marten619/RemoteController/HW design/PCB DIMENSIONS/RC-RF004-HCS200_V1.a PCB DIMENSIONS.PcbDoc.htm

Altium Reporting Options

# File in Newer Format

Date | : | 2017/11/13
Time | : | ¤U¤È 06:21:15
Filename | : | D:\Pmaster\Projects\Remote Control\HW design\PCB DIMENSIONS\RC-RF004-HCS200_V1.a PCB DIMENSIONS.PcbDoc

Version | Warning
Release 10 | CAUTION - New Custom Grids and Guides were introduced. Be aware that your design might contain Custom Grids and Guides that cannot be read in previous versions.
Release 10 | CAUTION - New Structured Clusters were introduced. Be aware that your design might contain Structured Clusters that cannot be read in previous versions.
Release 10 | CAUTION - New PCB 3D Movie Manager was introduced. Be aware that your design might contain 3D PCB movie that cannot be read in previous versions.
Release 10 update 1 | CAUTION - New Clearance Rule subscopes targeting differential pairs were introduced. Be aware that your design might contain Clearance Rules using those subscopes that cannot be read in previous versions.
Release 10 update 15 | CAUTION - Support of Solder Mask and Paste Mask expansions for Tracks, Arcs, Fills and Regions was introduced. Be aware that your design might contain Solder Mask and Paste Mask expansions for these types of primitives that cannot be read in the version of Altium Designer you are currently using.
Altium Designer update 19 | CAUTION - Air Gap Width attribute was introduced to Polygon Connect Style Rule. Be aware that your design might contain Polygon Connect Style Rules with new Air Gap Width attribute cannot be read in the version of Altium Designer you are currently using.

This file was generated by a later version of the software
