marten619/RemoteController/datasheet/TS06-050W.png

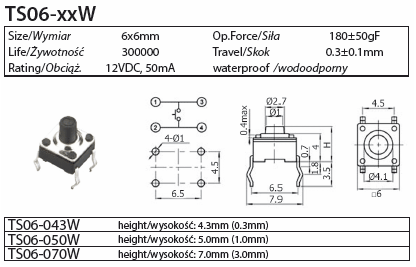
datasheet/TS06-050W.png
