marten619/RemoteController/HW design/BOM/Pmaster-A9112-HOST_1.xls

Sheet: BOM Report
Bill of Materials |  |  | Bill of Materials For PCB Document [Pmaster-A9112-HOST_1.PcbDoc]
Source Data From: |  | Pmaster-A9112-HOST_1.PcbDoc
Project: |  | Free Documents
Variant: |  | None
Creation Date: | 2017-11-21 | 18:13:43
Print Date: | 2018-06-29 | 10:14:47
Footprint | Comment | LibRef | Designator | Description | Quantity
BUZEER | BUZZER/TMB12A03 | BUZZER | B1 |  | 1
BAT-2 | Battery | Battery | BT1 | Multicell Battery | 1
A0402 | 10uF | CAP | C1 |  | 1
A0402 | 2.2uF | C/0603, CAP | C2, C5, C9, C17, C22, C23, C35, C36 | Chip C | 8
A0402 | 100pF | CAP | C3 |  | 1
A0402 | 22pF | C/0402 | C4, C7 | Chip C | 2
A0402 | 1uF | CAP | C6, C21 |  | 2
A0402 | 8.2pF | C/0603, CAP | C8, C19 | Chip C | 2
A0402 | 1nF | CAP | C10, C12 |  | 2
A0402 | NC | C/0603, RES1 | C11, C24, C25, R15 | Chip C | 4
A0402 | 2.7pF | CAP | C13 |  | 1
A0402 | 27pF | CAP | C14 |  | 1
A0402 | 22nF | C/1206 | C15 | Chip C | 1
A0402 | 0.1uF | C/0603, CAP | C16, C30, C31, C32, C33, C38 | Chip C | 6
A0402 | 470pF | CAP | C18 |  | 1
A0402 | 15pF | C/0603 | C20 | Chip C | 1
0805 | ?流二极管/1N4148 | Diode | D1 | Default Diode | 1
HDR2_2.54 | Comment |  | J2, J3, J4, J5, J6, J7, J8 |  | 7
HDR4_2.54 | Comment |  | J9 |  | 1
A0402 | 39nH | L/0402 | L1 | Chip L | 1
A0402 | 33nH | L/0402 | L2 | Chip L | 1
A0402 | 22nH | L/0603 | L3, L4 |  | 2
A0402 | 0 | L/0603, R/0603, RES1 | L5, R1, R3, R4, R5, R14 | Chip R | 6
A0603 | GREEN |  | LED1 |  | 1
A0603 | RED |  | LED2 |  | 1
SOT23_N | 8050_NPN | NPN | Q1 | NPN Bipolar Transistor | 1
A0402 | 100K | R/0402 | R2 | Chip R | 1
A0402 | 50 | L/0603 | R6 |  | 1
A0402 | 4.7k | RES1 | R10, R11 |  | 2
A0402 | 330 | RES1 | R12, R17 |  | 2
A0402 | 1k | RES1 | R16 |  | 1
SW-SMD | SW-PB | SW-PB | S1/P3.5, S2/P3.4, S3/P3.3, S4/P3.2 |  | 4
QFN40_5*5 | A9112F4 | A9112F4 | U1 |  | 1
DFN-MC8 | Comment |  | U2 |  | 1
SOT-23_N | LP3995-33B3F | REG\G903\3.3V\SOT-223 | U3 | GMT 3.3V REGULTOR | 1
MSOP-MS8_N | EEPROM_24AA16 | EEPROM_24AA16 | U4 |  | 1
XTAL_3.2*2.5 | 12.8MHz/CL=20pF |  | Y1 |  | 1
XTAL_3215 | 32.768KHz | CRYSTAL | Y2 | Crystal | 1
 |  |  |  |  | 74
Approved |  | Notes

Sheet: Project Information
Project Full Path | Free Documents
Project Filename | Free Documents
Variant Name | None
Data-Source Filename | Pmaster-A9112-HOST_1.PcbDoc
Data-Source Full Path | D:\Pmaster\Projects\Remote Control\HW design\Pmaster-A9112-HOST_1.PcbDoc
Title | Bill of Materials For PCB Document [Pmaster-A9112-HOST_1.PcbDoc]
Total Quantity | 74
Report Time | 18:13:43
Report Date | 2017-11-21
Report Date & Tine | 2017-11-21 18:13
Output Name | Bill of Materials
Output Type | BOM_PartType
Output Generator Name | ReportComponents
Output Generator Description | Component Reports
