marten619/RemoteController/HW design/BOM/Pmaster-A9112-remote-1.xls

Comment | Description | Designator | Footprint | LibRef | Quantity
10uF |  | C1 | A0402 | CAP | 1.0
2.2uF | Chip C | C2, C5, C9, C17, C22, C23, C35, C36 | A0402 | C/0603, CAP | 8.0
100pF |  | C3 | A0402 | CAP | 1.0
1uF |  | C6, C21 | A0402 | CAP | 2.0
8.2pF | Chip C | C8, C19 | A0402 | C/0603, CAP | 2.0
1nF |  | C10, C12 | A0402 | CAP | 2.0
NC | Chip C | C11, C38, C39 | A0402 | C/0603 | 3.0
2.7pF |  | C13 | A0402 | CAP | 1.0
27pF |  | C14 | A0402 | CAP | 1.0
22nF | Chip C | C15 | A0402 | C/1206 | 1.0
0.1uF |  | C16, C30, C31, C32, C33 | A0402 | CAP | 5.0
470pF |  | C18 | A0402 | CAP | 1.0
15pF | Chip C | C20 | A0402 | C/0603 | 1.0
Comment |  | J2, J3 | HDR6_2.0 |  | 2.0
39nH | Chip L | L1 | A0402 | L/0402 | 1.0
33nH | Chip L | L2 | A0402 | L/0402 | 1.0
22nH |  | L3, L4 | A0402 | L/0603 | 2.0
0 | Chip R | L5, R1, R3, R4, R5 | A0402 | L/0603, R/0603, RES1 | 5.0
 |  | LED/GREEN, LED/RED | 0603 | CAP | 2.0
100K | Chip R | R2 | A0402 | R/0402 | 1.0
50 |  | R6 | A0402 | L/0603 | 1.0
4.7k |  | R10, R11 | A0402 | RES1 | 2.0
330 |  | R12, R13 | A0402 | RES1 | 2.0
SW-PB |  | SW1, SW2, SW3, SW4 | SW-SMD | SW-PB | 4.0
A9112F4 |  | U1 | QFN40_5*5 | A9112F4 | 1.0
Comment |  | U2 | DFN-MC8 |  | 1.0
LP3995-33B3F | GMT 3.3V REGULTOR | U3 | SOT-23_N | REG\G903\3.3V\SOT-223 | 1.0
Comment |  | Y1 | XTAL_3.2*2.5 |  | 1.0
