marten619/RemoteController/HW design/PCB DIMENSIONS/RC-RF004-HCS200_V1.a PCB DIMENSIONS.DXF

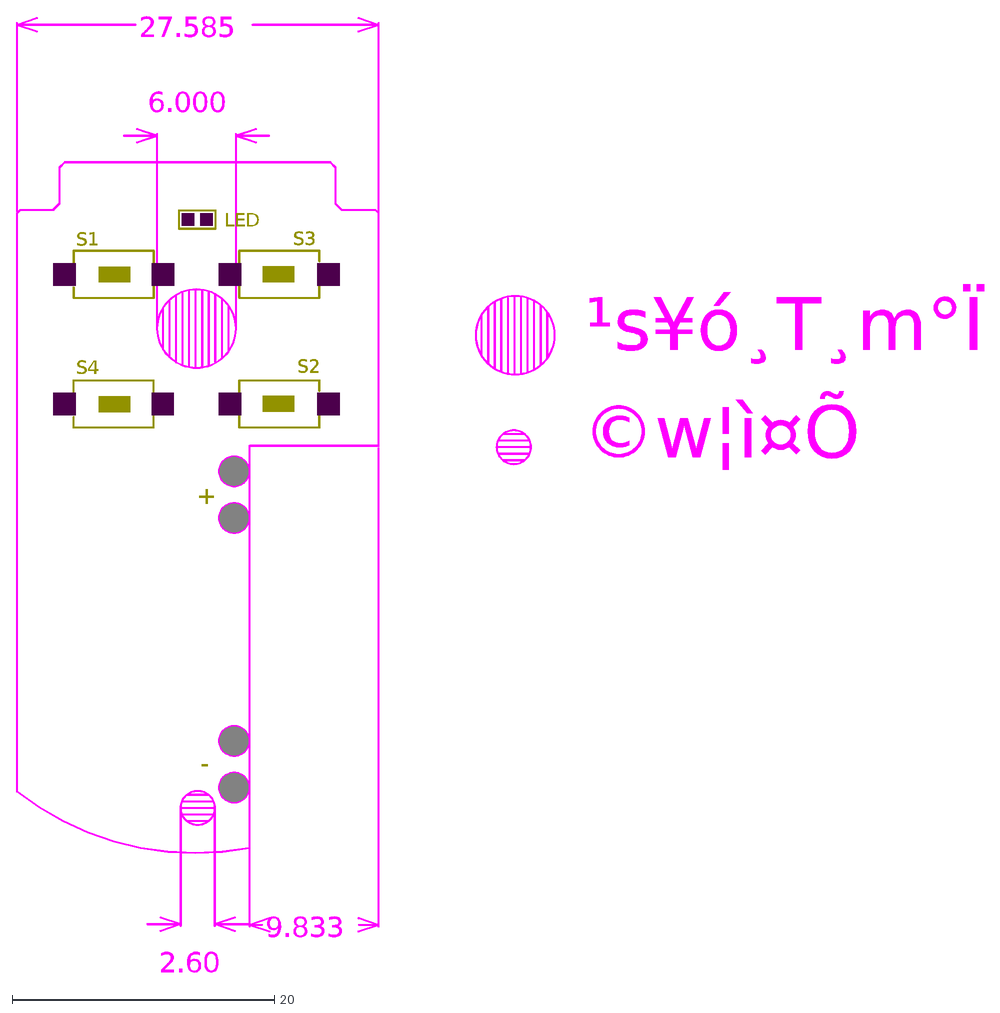
[picture p22: CAD file, 2018-06-29]
HW design/PCB DIMENSIONS/RC-RF004-HCS200_V1.a PCB DIMENSIONS.DXF
+
-
¹s¥ó¸T¸m°Ï
©w¦ì¤Õ
2.60
6.000
27.585
9.833
LED
S3
S2
S4
S1
