marten619/RemoteController/(list of files, cad)

Other CAD files:
Source codes/Host/keil/main.obj
Source codes/FOB/keil/main.obj
Source codes/FOB/keil/MasterI2C.obj
Source codes/Host/keil/SHA_I2C.obj
Source codes/FOB/keil/A9112F4_Function.obj
Source codes/Host/keil/MCU.obj
Source codes/FOB/keil/STARTUP_AMC1.obj
Source codes/FOB/keil/MCU.obj
Source codes/Host/keil/MasterI2C.obj
Source codes/Host/keil/STARTUP_AMC1.obj
Source codes/FOB/keil/SHA_I2C.obj
Source codes/Host/keil/Uti.obj
Source codes/FOB/keil/Uti.obj
Source codes/Host/keil/A9112F4_Function.obj
