marten619/RemoteController/HW design/SCH and PCB/A9112 FOB SCH.pdf

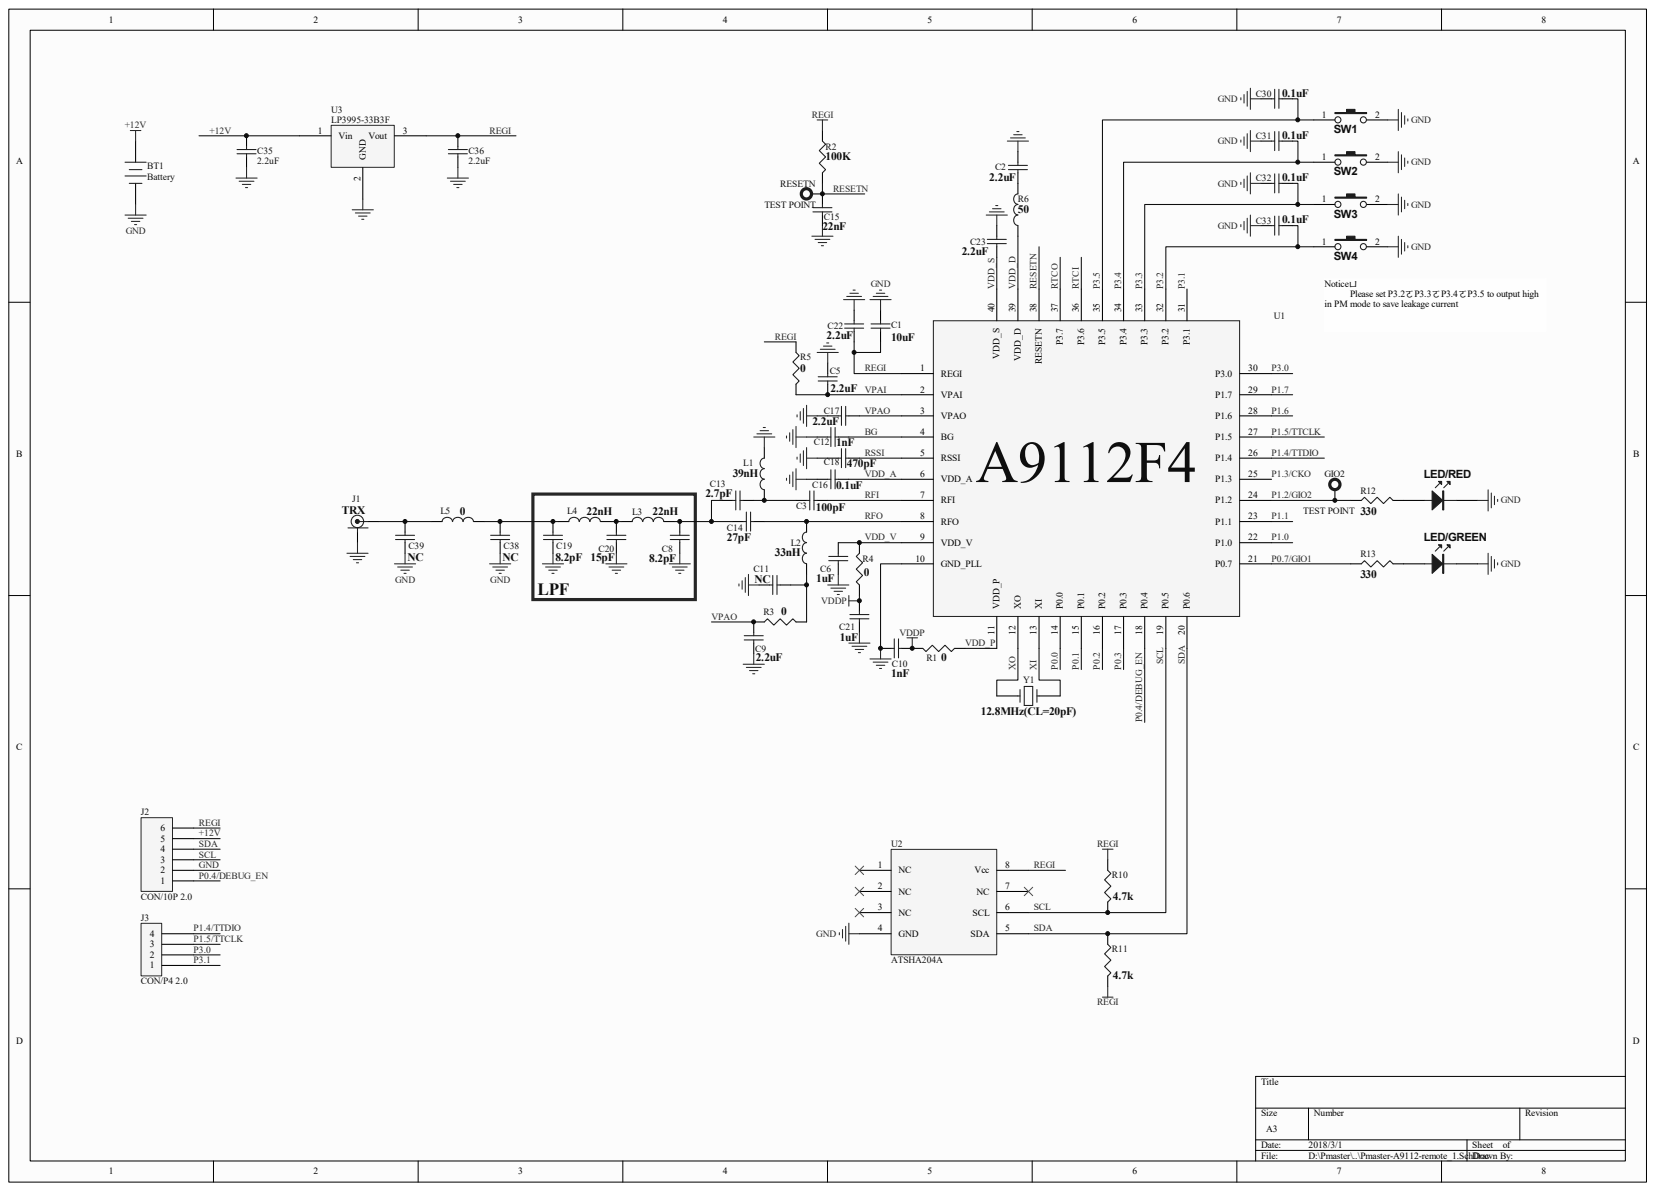
[picture p23: page 1]

Noticeㄩ
Please set P3.2ㄛP3.3ㄛP3.4ㄛP3.5 to output high
in PM mode to save leakage current
