marten619/RemoteController/HW design/PCB DIMENSIONS/RC-RF004-HCS200_V1.a PCB DIMENSIONS.PDF.pdf

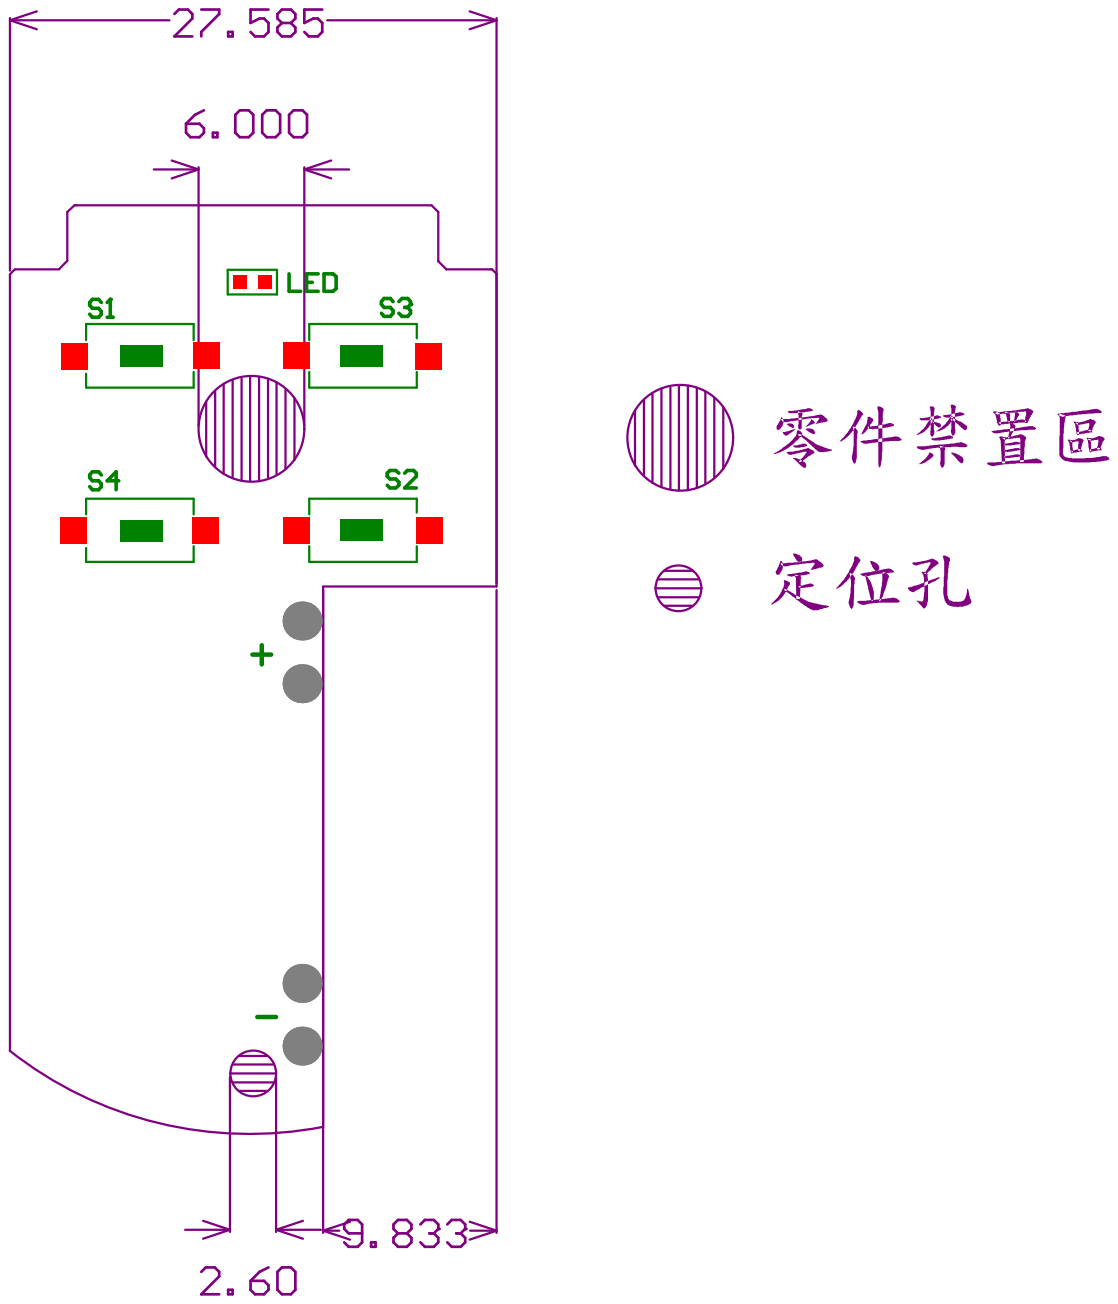
[picture p24: page 1]
