marten619/RemoteController/(list of files, drawings)

Other design files:
HW design/PCB DIMENSIONS/RC-RF004-HCS200_V1.a PCB DIMENSIONS.pcb
HW design/PCB DIMENSIONS/RC-RF004-HCS200_V1.a PCB DIMENSIONS.PcbDoc
HW design/SCH and PCB/Pmaster-A9112-HOST_0.SchDoc
HW design/SCH and PCB/Pmaster-A9112-HOST_1.PcbDoc
HW design/SCH and PCB/Pmaster-A9112-HOST_1.SchDoc
HW design/SCH and PCB/Pmaster-A9112-remote-1.PcbDoc
HW design/SCH and PCB/Pmaster-A9112-remote_1.SchDoc
