marten619/RemoteController/Source codes/FOB/MCU/uti.h

/*********************************************************************
**  File:       Uti.h
**  Updated:    2016-05-13
**  Description:
**  This file is the delay function header.
**
**  Copyright (C) 2016 AMICCOM Corp.
**
*********************************************************************/
#ifndef _UTI_H_
#define _UTI_H_


extern void Delay10us(Uint8);
extern void Delay100us(Uint8);
extern void Delay1ms(Uint8);
extern void Delay10ms(Uint8);

#endif
